vitorfleonardo/ESP32-Rocket-Telemetry/README.md

 

<h1 align="center">🚀 Foguete d'Água com Base Automatizada 🚀</h1>
<p align="center">
  Projeto Interdisciplinar - Faculdade UnB Gama<br>
  <strong>Engenharias Aeroespacial, Eletrônica, Software, Automotiva e Energia</strong> – 2025<br>
  <em>Controle de Trajetória, Automação e Análise de Dados</em>
</p>

---

## 📘 Sobre o Projeto

Este repositório contém o projeto **"Foguete d’Água com Base Automatizada"**, desenvolvido como parte da disciplina **Projeto Integrador de Engenharia 1 (PI1)** da Universidade de Brasília (UnB). O sistema foi concebido para realizar lançamentos de foguetes com **propulsão hidrostática** de forma segura, reutilizável e com **coleta de dados embarcada**.

> 🎯 **Objetivo**: Alcançar distâncias pré-definidas de 10 m, 20 m e 30 m com precisão de ±0.5 m, coletando e processando dados em tempo real por meio de um microcontrolador embarcado (ESP32). Após o voo, construir análises da trajetória.

---

## EQUIPE DO PROJETO

<div align="center">
  <h3>TIME DE HARDWARE</h3>
  <table>
    <tr>
      <td align="center">
      <a href="https://github.com/vitorfleonardo">
        
        <br />
        <b>Vitor Feijó</b>
        <br />
        <sub>Gerente do Projeto</sub>
      </a>
    </td>
    <td align="center">
      <a href="https://github.com/luidooo">
        
        <br />
        <b>Luis Lima</b>
        <br />
        <sub>Gerente de Hardware</sub>
      </a>
    </td>
    <td align="center">
      <a href="https://github.com/bottinolucas">
        
        <br />
        <b>Lucas Bottino</b>
        <br />
        <sub>Engenheiro de Hardware</sub>
      </a>
    </td>
    <td align="center">
      <a href="https://github.com/R-enanVieira">
        
        <br />
        <b>Renan Vieira</b>
        <br />
        <sub>Engenheiro de Hardware</sub>
      </a>
    </td>
    </tr>
  </table>

  <h3>TIME DE SOFTWARE</h3>
  <table>
    <tr>
      <td align="center">
        <a href="https://github.com/melohugo">
          
          <br />
          <b>Hugo Melo</b>
          <br />
          <sub>Gerente de Software</sub>
        </a>
      </td> 
      <td align="center">
        <a href="https://github.com/BeyondMagic">
          
          <br />
          <b>João V. Farias</b>
          <br />
          <sub>Engenheiro de Software</sub>
        </a>
      </td> 
      <td align="center">
        <a href="https://github.com/LuizaMaluf">
          
          <br />
          <b>Luiza Maluf</b>
          <br />
          <sub>Engenheira de Software</sub>
        </a>
      </td>
      <td align="center">
        <a href="https://github.com/Nanashii76">
          
          <br />
          <b>Paulo H. Lamounier</b>
          <br />
          <sub>Engenheiro de Software</sub>
        </a>
      </td>
      <td align="center">
        <a href="https://github.com/MillenaQueiroz">
          
          <br />
          <b>Millena Queiroz</b>
          <br />
          <sub>Engenheira de Software</sub>
        </a>
      </td>
    </tr>
  </table>

   <h3>TIME DE ESTRUTURAS</h3>
   <table>
    <tr>
      <td align="center">
        
        <br />
        <b>Ives Monteiro</b>
        <br />
        <sub>Gerente de Estruturas</sub>
      </td>
      <td align="center">
          
          <br />
          <b>Sophia Cordeiro</b>
          <br />
          <sub>Engenheira de Estruturas</sub>
      </td>
      <td align="center">
          
          <br />
          <b>Guilherme Carmona</b>
          <br />
          <sub>Engenheiro de Estruturas</sub>
      </td>
      <td align="center">
          
          <br />
          <b>Erik Moreira</b>
          <br />
          <sub>Engenheiro de Estruturas</sub>
      </td>
      <td align="center">
        <a href="https://github.com/kaedcanizo1">
          
          <br />
          <b>Kaed Caniz</b>
          <br />
          <sub>Engenheiro de Estruturas</sub>
        </a>
      </td>
    </tr>
  </table>

</div>

---

## 🛠️ Módulos do Projeto

<div align="center">
    <h3>ESTRUTURAS DA BASE DE LANÇAMENTO E DO FOGUETE</h3>
    Diagrama de Hardware
    <p> Imagem 1 - Construção, design e resultado final da Base de Lançamentos e do Foguete.</p>
</div>

<div>
    Na parte de estruturas, realizamos o design da Base de Lançamentos e do Foguete com o CAD, como exemplificado em (b). Logo em seguida iniciamos a montagem do foguete como em (a) e ao final obtivemos o resultado mostrado em (c).
</div>

---

<div align="center">
    <h3>HARDWARE DO FOGUETE</h3>
    Diagrama de Hardware
    <p> Imagem 2 - Evolução do protótipo do hardware interno do foguete.</p>
</div>

<div>
Iniciamos a construção do hardware com o prototipo (a), testando o MPU-6050 com o protocolo I2C com a ESP32. Logo após aumentamos a complexidade e testamos o sistema completo com ESP32, MPU-6050 e armazenamento no Micro SD, exeplificado no protitipo (b). Em seguida realizamos uma soldagem com barras de pino em uma placa perfurada, representado pelo prototipo (c). E por fim, soldando as baterias ao dispositivo obtivemos o protitipo final (d).
</div>

---

<div align="center">
    <h3>HARDWARE DA BASE DE LANÇAMENTOS</h3>
    Hardware da base
    <p> Imagem 3 - Dispositivo hardware da Base.</p>
</div>

<div>
Assim que a quantidade de pressão é ideial, com base na leitura do manômetro, ativa-se então o hardware da base que faz uma contagem regressiva de 10 segundos e atuomaticamente faz uma acionamento eletromecânico na base lançando o foguete. 
</div>

---

<div align="center">
    <h3>SOFTWARE DE TELEMETRIA</h3>
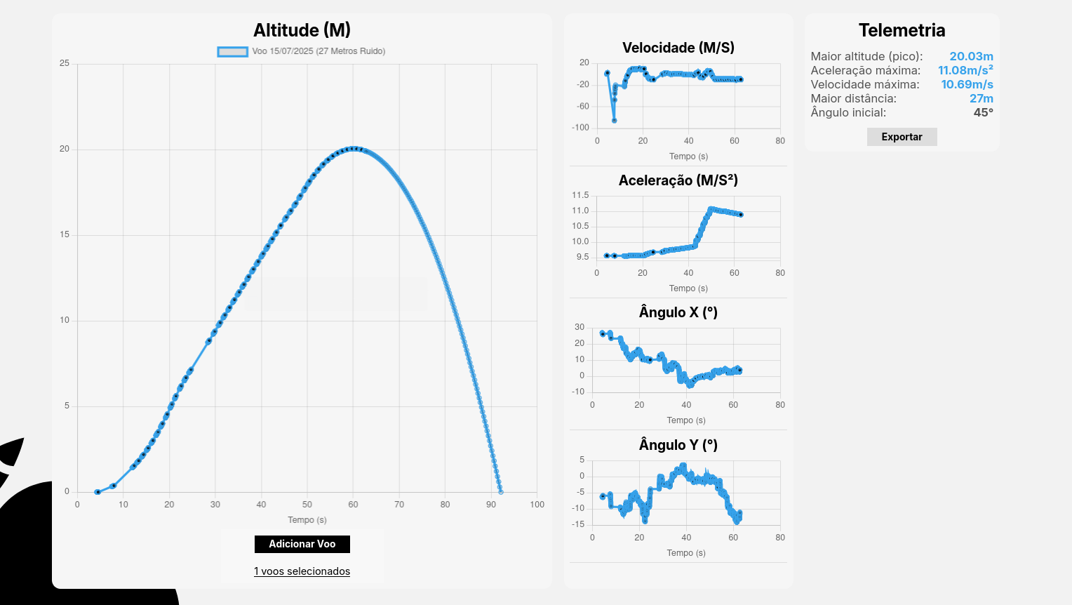
[picture p1: media/telemetria.jpeg]
Telemetria do Software
    
    <p> Imagem 4 - Software para análise do lançamento.</p>
</div>

<div>
Com o SD card do Harwade do Foguete conseguimos obter os dados de timestamp, acelerações linerares (ax, ay e az), giro (gx, gy e gz) e por um processamento que consiste em conversão e aplicação de formulas físicas podemos construir gráficos e análises da trajetória do foguete.
</div>

---

📜 Licença
MIT License © 2025 Foguete d'Água com Base Automatizada
