vitorfleonardo/ESP32-Rocket-Telemetry/software/latex/editaveis/01_abreviaturas.tex

\begin{siglas}
	\item[EAP] Estrutura Analítica do Projeto
	\item[TAP] Termo de Abertura do Projeto
	\item[SWOT] Forças (\textit{Strength}), Fraquezas (\textit{Weakness}), Oportunidades (\textit{Opportunities}), Ameaças (\textit{Threats})
	\item[PMBOK] \textit{Project Management Body of Knowledge} (guia das melhores práticas do gerenciamento de projetos)
	\item[CAD] Ferramenta para criação de desenhos técnicos
	\item[DER] Diagrama de Entidade e Relacionamento
	\item[BACKLOG] Lista de atividades de execução do projeto
	\item[FCTE] Faculdade de Ciências e Tecnologias de Engenharia
	\item[KICKOFF] uma reunião com a equipe do projeto e o cliente do projeto
	\item[BPMN] Business Process Model and Notation
	\item[PET] Tipo de plástico usado para fazer garrafas
	\item[TAP] Termo de Abertura de Projetos
	\item[AEB] Agência Espacial Brasileira
	\item[ESP32] Placa de desenvolvimento de hardware aberto
	\item[CLI] Interface de Linha de Comando
	\item[API] Interface de Programação de Aplicações
	\item[GUI] Interface Gráfica do Usuário
	\item[PSAI] Poliestireno de Alto Impacto
	\item[PVC] Policloreto de Vinila
	\item[CAD] Computer-Aided Design (Desenho Assistido por Computador)
	\item[CATIA] Computer-Aided Three-dimensional Interactive Application (Aplicação Interativa Assistida por Computador em Três Dimensões)
	\item[CSV] Comma-Separated Values (Valores Separados por Vírgula)
	\item[IMU] Unidade de Medição Inercial
	\item[SD] Secure Digital (Cartão de Memória)
	\item[PC] Personal Computer (Computador Pessoal)
\end{siglas}
