vitorfleonardo/ESP32-Rocket-Telemetry/software/README.md

# Projeto de Documentação

Este repositório contém o primeiro cliente de visualização em Python e a documentação em Markdown do programa.

## 🚀 Como rodar localmente

1. Clone o repositório:

```bash
git clone https://github.com/melohugo/PI1.git
cd PI1
```

1. Crie um ambiente virtual e instale as dependencias:

```bash
python -m venv .venv

source .venv/bin/activate  # no Linux/macOS
# ou
.venv\Scripts\activate  # no Windows

pip install -r requirements.txt
```

### Python

1. Instalar as depêndencias do cliente:

```bash
pip install -r source/requirements.txt
```

1. Executar programa:

```bash
python source/__init__.py
```

### Documentação

1. Executar a documentação

```bash
mkdocs serve
```

<!--
### Para mais detalhes de como contribuir, consulte o arquivo CONTRIBUTING.md

🛠️ Projeto em construção.
-->
