vitorfleonardo/ESP32-Rocket-Telemetry/software/docs/planejamento/tap.md

# Termo de Abertura do Projeto

## Nome do Projeto: Foguete de Água

Data de Início: 21/04/2025

Data Estimada de Término: 26/07/2025

## 1. Justificativa

Os alunos estão cursando a matéria Projeto Integrador 1 (PI1), e o desafio proposto é construir um foguete de água capaz de alcançar distâncias de 10, 20 e 30 metros. Para a parte de software, é necessário realizar uma análise dos dados coletados pelo foguete durante o voo.

## 2. Objetivos do Projeto

a. Objetivo Geral:

Desenvolver um foguete de água capaz de alcançar 10, 20 e 30 metros até o dia 06 de junho de 2025. O foguete não pode ser trocado durante a avaliação final.

b. Objetivos Específicos:

- Realizar análise dos dados adquiridos durante o lançamento.
- Elaborar um plano de projeto.
- Utilizar e documentar técnicas de gerenciamento de projeto.
- Aplicar testes nos componentes.

## 3. Escopo do Projeto

Incluído no Escopo:

- Levantamento e análise de requisitos.
- Confecção da documentação do sistema.
- Codificação da solução.
- Criação da documentação exigida pela matéria.

Fora do Escopo:

- Mudanças organizacionais de nível estratégico.
- Contratação de pessoal externo.
- Alterações na estrutura jurídica da empresa.

## 4. Premissas

- Os membros da equipe participarão ativamente das atividades.
- Haverá disponibilidade de tempo dos membros-chave para entrevistas e validações.
- O projeto terá apoio dos professores.

## 5. Restrições

- Orçamento limitado.
- Pouco conhecimento dos membros em temas específicos.
- Projeto executado com carga horária limitada.

## 6. Principais Partes Interessadas

- Membros da equipe.

## 7. Riscos Iniciais Identificados

- Baixo engajamento durante a implementação.
- Falta de conhecimento prévio sobre metodologias de gestão.
