vitorfleonardo/ESP32-Rocket-Telemetry/software/latex/editaveis/00_informacoes.tex

% Dados pessoais
\autor{Arthur Henrique Vieira, Erick Tavares, Guilherme Resende, Hugo Queiroz, Ives Monteiro, João Victor da Silva, Kaed Canizo, Leonardo Henrique, Lucas Gama, Luis Eduardo Castro, Luiza Maluf, Millena de Abreu, Natan Almeida, Paulo Henrique Lamounier, Renan Vieira, Sophia Souza, Sophia Ferreira, Vitor Feijó}
\curso{}

% Dados do trabalho
\titulo{Projeto de PI1}
\data{2025}
\palavraChaveUm{Projeto Integrador de Engenharia 1}
\palavraChaveDois{Faculdade UnB Gama}
\palavraChaveTres{Foguete d'água}
\palavraChaveQuatro{Controle de trajetória}
\palavraChaveCinco{Sistema embarcado}

% Dados da orientacao
\orientador{Prof. Ricardo Ajax Dias Kosloski}
\coorientador{Prof. Diogo Caetano Garcia, Prof. Juliana Petrocchi Rodrigues, Prof. Lui Txai Calvoso Habl e Prof. Rafael Rodrigues da Silva}

% % Dados para a ficha catalográfica
% \cdu{02:141:005.6}

% % Dados da aprovação do trabalho
% \dataDaAprovacao{01 de junho de 2013 -- Data da aprovação do trabalho}
% \membroConvidadoUm{Titulação e Nome do Professor Convidado 01}
% \membroConvidadoDois{Titulação e Nome do Professor Convidado 02}
