vitorfleonardo/ESP32-Rocket-Telemetry/software/latex/editaveis/05_equipe.tex

\begin{landscape}

\chapter{Equipe de Trabalho}

\begin{table}[htpb]
\begin{center}
\caption{Composição da equipe.}
\begin{tabular}{|c|c|c|c|c|c|c|}
\hline
\textbf{Iniciais} & \textbf{Nome} & \textbf{Matrícula} & \textbf{Curso} & \textbf{Telefone} & \textbf{E-mail} & \textbf{Atribuições}\\ \hline
AV & Arthur Vieira        & 23/1034064        & Eng. de Software      & (61) 98604-5333   & 231034064@aluno.unb.br   & Engenheiro de Software \\ \hline
EM & Erick Moreira         & 22/2022073        & Eng. de Aeroespacial  & (61) 99121-2563   & 222022073@aluno.unb.br   & Engenheiro de Estruturas \\ \hline
GC & Guilherme Carmona     & 22/1008070        & Eng. de Aeroespacial  & (61) 98128-8772   & 221008070@aluno.unb.br   & Engenheiro de Estruturas \\ \hline
HM & Hugo Melo             & 23/1034064        & Eng. de Software      & (61) 99547-0505   & 231034064@aluno.unb.br   & \textbf{Gerente} de \textit{Software} \\ \hline
IL & Ives Lemos            & 22/1008122        & Eng. de Aeroespacial  & (61) 99966-5115   & 221008122@aluno.unb.br   & \textbf{Gerente} de Estruturas \\ \hline
JF & João Farias           & 22/1022604        & Eng. de Software      & (61) 92002-3350   & 221022604@aluno.unb.br   & Engenheiro de \textit{Software} \\ \hline
KP & Kaed Prado            & 22/1008220        & Eng. de Aeroespacial  & (92) 98149-3839   & 221008220@aluno.unb.br   & Engenheiro de estruturas \\ \hline
LJ & Leonardo Junior       & 23/1035428        & Eng. de Software      & (61) 98531-1586   & 231035428@aluno.unb.br   & Engenheiro de Software \\ \hline
LB & Lucas Bottino         & 22/1008267        & Eng. de Software      & (61) 99149-8776   & 221008267@aluno.unb.br   & Engenheiro de \textit{Hardware} \\ \hline
LL & Luis Lima             & 22/1008285        & Eng. de Software      & (61) 99961-8010   & 221008285@aluno.unb.br   & \textbf{Gerente} de Hardware \\ \hline
LA & Luiza Amorim          & 22/1008294        & Eng. de Software      & (61) 99845-4712   & 221008294@aluno.unb.br   & Engenheiro de \textit{Software} \\ \hline
MQ & Millena Queiroz       & 20/2046283        & Eng. de Software      & (61) 99250-1026   & 202046283@aluno.unb.br   & Engenheiro de \textit{Software} \\ \hline
NA & Natan Almeida         & 22/2006169        & Eng. de Software      & (61) 99841-7222   & 222006169@aluno.unb.br   & Engenheiro de \textit{software} \\ \hline
PD & Paulo Dantas          & 22/1022408        & Eng. de Software      & (61) 98156-3664   & 221022408@aluno.unb.br   & Engenheiro de \textit{Software} \\ \hline
RG & Renan Guedes          & 22/1031363        & Eng. de Software      & (61) 99542-2260   & 221031363@aluno.unb.br   & Engenheiro de Hardware \\ \hline
SC & Sophia Cordeiro       & 22/1008454        & Eng. de Aeroespacial  & (18) 99783-6296   & 221008454@aluno.unb.br   & Engenheiro de Estruturas \\ \hline
SS & Sophia Silva          & 23/1026886        & Eng. de Software      & (61) 98260-6252   & 231026886@aluno.unb.br   & Engenheiro de \textit{software} \\ \hline
VL & Vitor Leonardo        & 22/1008516        & Eng. de Software      & (61) 99243-6348   & 221008516@aluno.unb.br   & \textbf{Gerente} do projeto \\ \hline
\end{tabular}
\end{center}
\end{table}

% \begin{table}[htpb]
% \begin{center}
% \caption{Avaliação de desempenho da equipe \textcolor{red}{(a ser preenchida na entrega final do projeto)}.}
% \begin{tabular}{|c|c|c|c|c|c|c|c|}
% \hline
%  & \textbf{Avaliação} & \textbf{Moti-} & \textbf{Comprome-} & \textbf{Conhecimento} & \textbf{Cumpriu} & \textbf{Comuni-} & \textbf{Gestão} \\
%  \textbf{Nome} & \textbf{geral} & \textbf{vação} & \textbf{timento} & \textbf{técnico} & \textbf{prazos} & \textbf{cação} & \textbf{de conflitos} \\ \hline
% Fulano & +++ & +++++ & +++++ & +++ & +++ & + & +++ \\ \hline
% Beltrano & +++ &  +++ & +++ & + & +++ & +++++ & +++ \\ \hline
% %  &  &  &  &  &  &  & em mais de uma linha \\\hline
% Ciclano & +++++ & +++ &  +++++ & +++ & +++ & +++ & +++  \\ \hline
%   &  &  &  &  &  &  &     \\ \hline
%   &  &  &  &  &  &  &     \\ \hline
%   &  &  &  &  &  &  &     \\ \hline
%   &  &  &  &  &  &  &     \\ \hline
%   &  &  &  &  &  &  &     \\ \hline
%   &  &  &  &  &  &  &     \\ \hline
%   &  &  &  &  &  &  &     \\ \hline
%   &  &  &  &  &  &  &     \\ \hline
%   &  &  &  &  &  &  &     \\ \hline
%   &  &  &  &  &  &  &     \\ \hline
%   &  &  &  &  &  &  &     \\ \hline
%   &  &  &  &  &  &  &     \\ \hline
% \multicolumn{8}{c}{\textit{Legenda}: +++++: \textit{atende às expectativas}; +++: \textit{requer pequenas melhorias}; +: \textit{requer grandes melhorias}.} 
% \end{tabular}
% \end{center}
% \end{table}

\end{landscape}
