vitorfleonardo/ESP32-Rocket-Telemetry/software/latex/figuras/capa-eps-converted-to.pdf

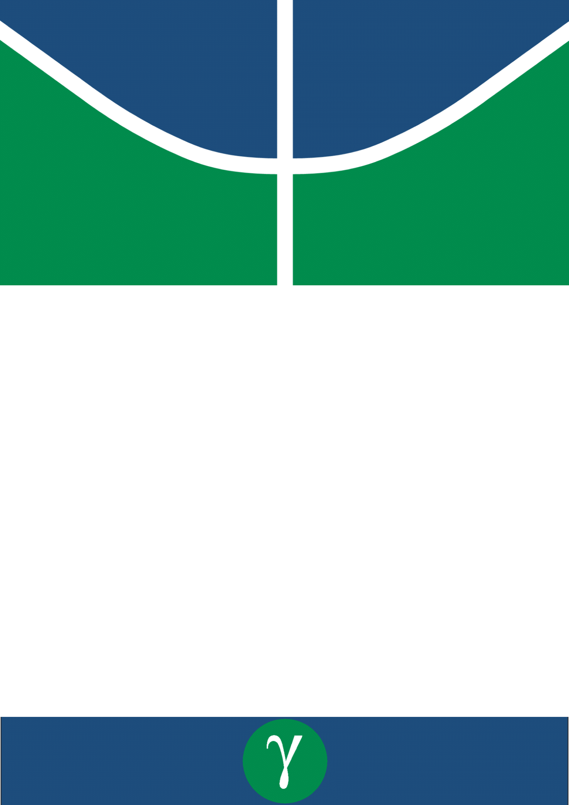
[picture p44: page 1]
