vitorfleonardo/ESP32-Rocket-Telemetry/media/CCC38DA5-3B44-47A4-BD88-0B7C26B4D97B.JPG

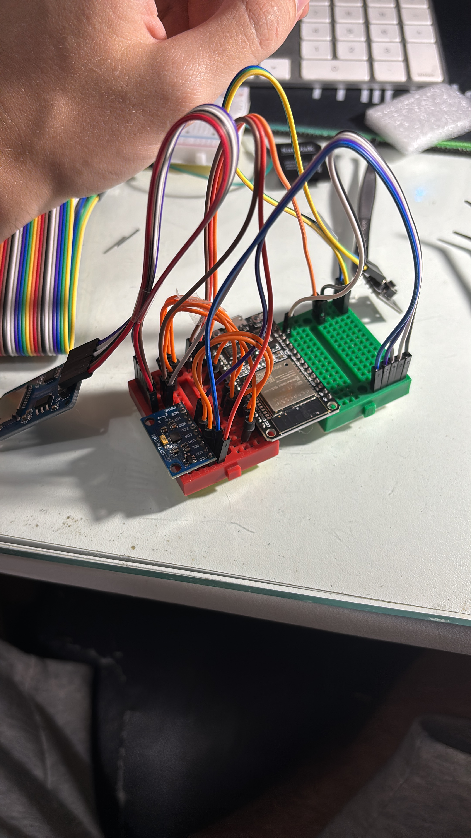
media/CCC38DA5-3B44-47A4-BD88-0B7C26B4D97B.JPG
