vitorfleonardo/ESP32-Rocket-Telemetry/media/foto.jpg

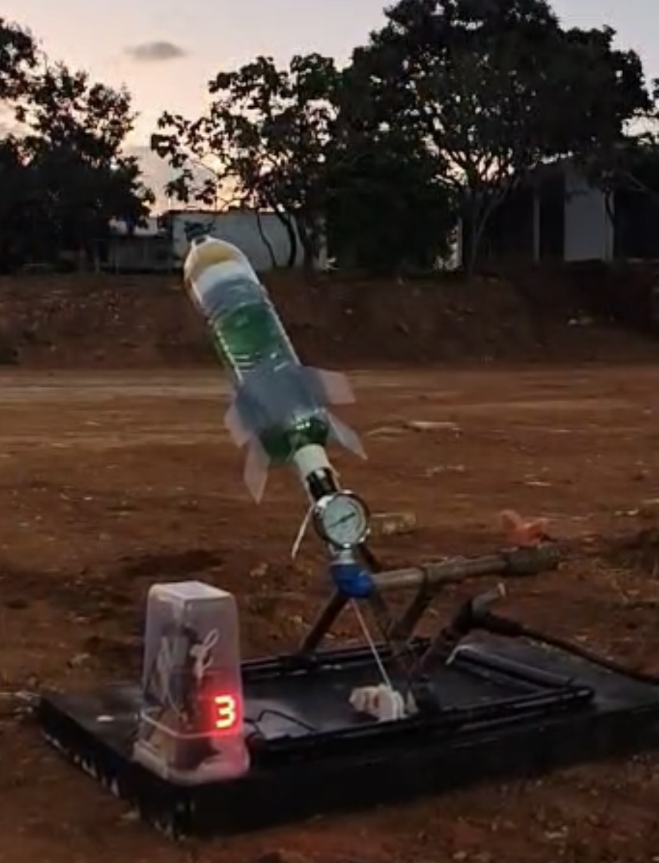
media/foto.jpg
