vitorfleonardo/ESP32-Rocket-Telemetry/media/hardware_1.JPG

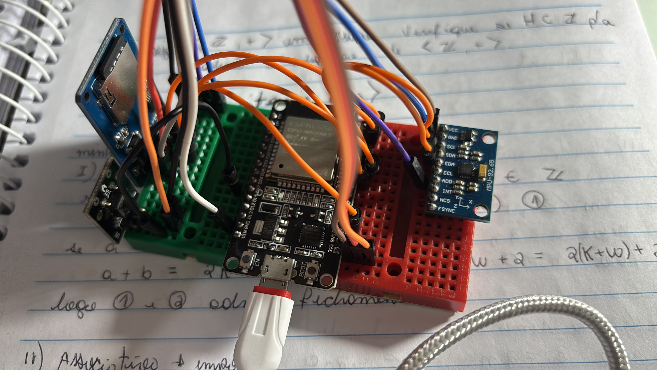
media/hardware_1.JPG
