vitorfleonardo/ESP32-Rocket-Telemetry/media/hardware_2.jpg

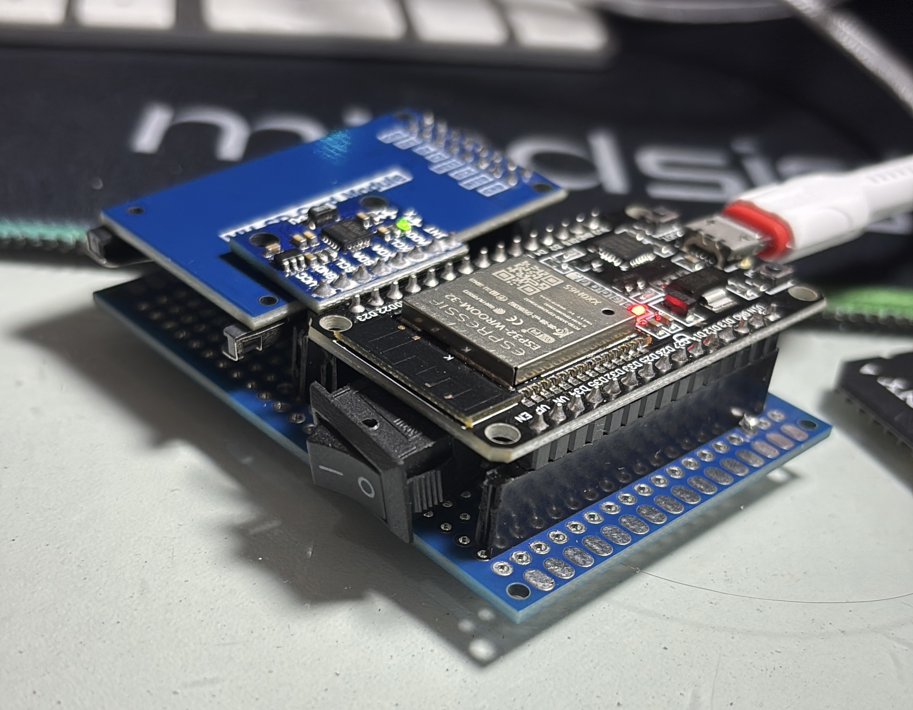
media/hardware_2.jpg
