vitorfleonardo/ESP32-Rocket-Telemetry/software/latex/figuras/arquitetura.png

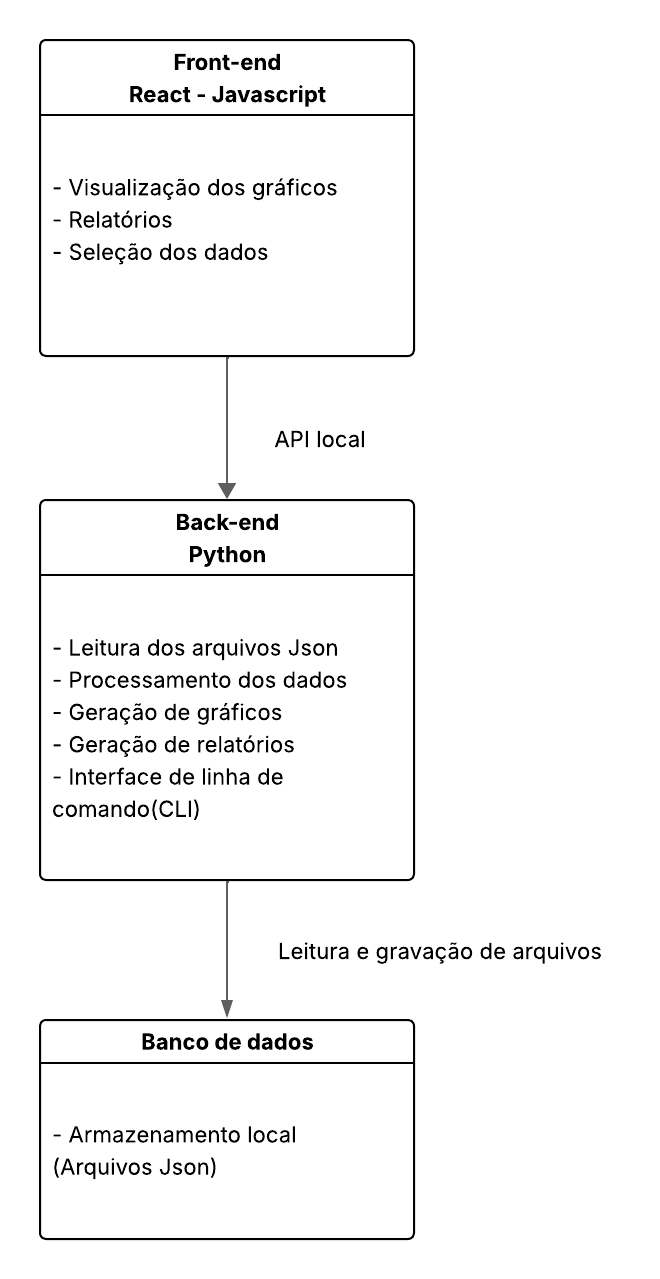
software/latex/figuras/arquitetura.png
