vitorfleonardo/ESP32-Rocket-Telemetry/software/latex/figuras/back_log.png

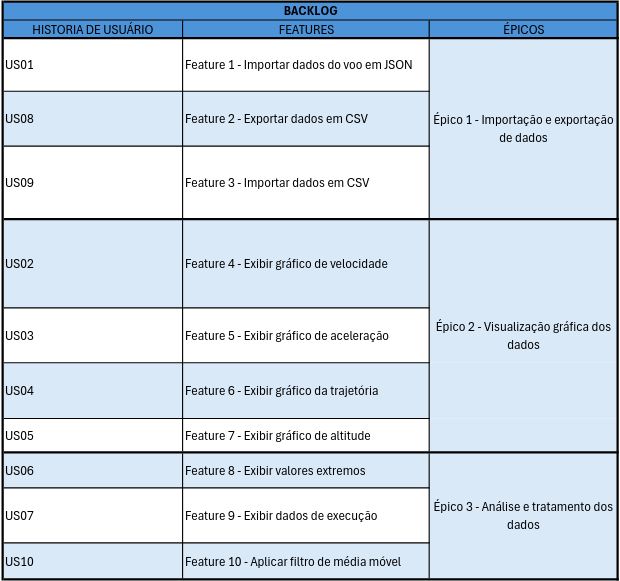
software/latex/figuras/back_log.png
