vitorfleonardo/ESP32-Rocket-Telemetry/software/latex/figuras/bpmn.png

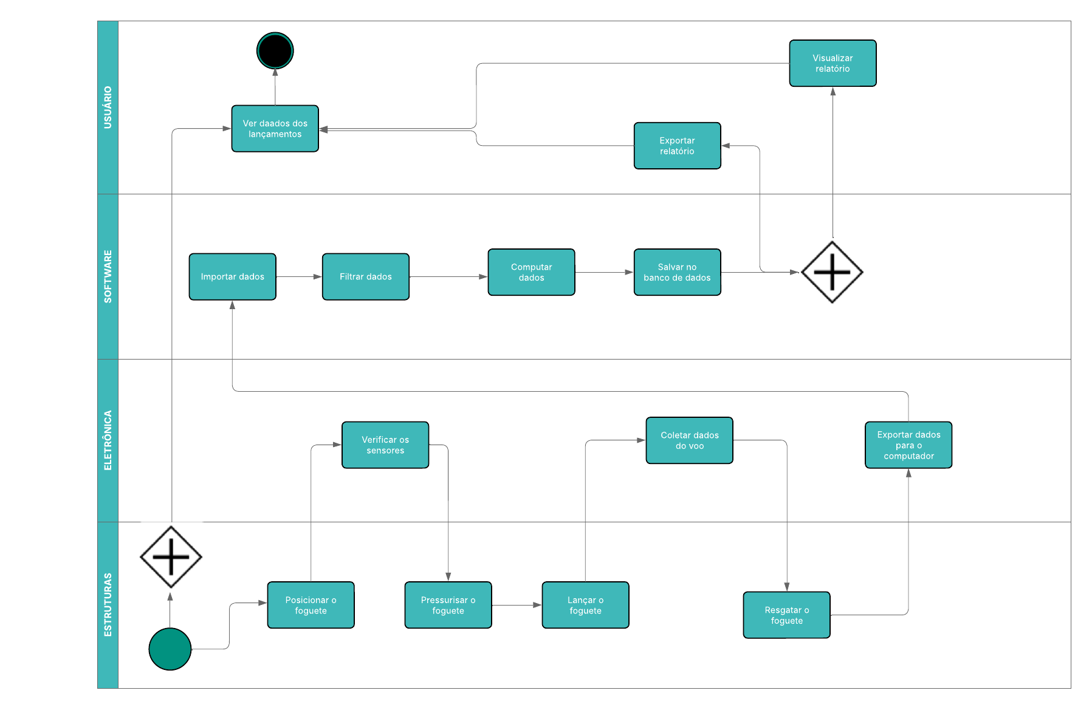
software/latex/figuras/bpmn.png
