vitorfleonardo/ESP32-Rocket-Telemetry/software/latex/figuras/der.png

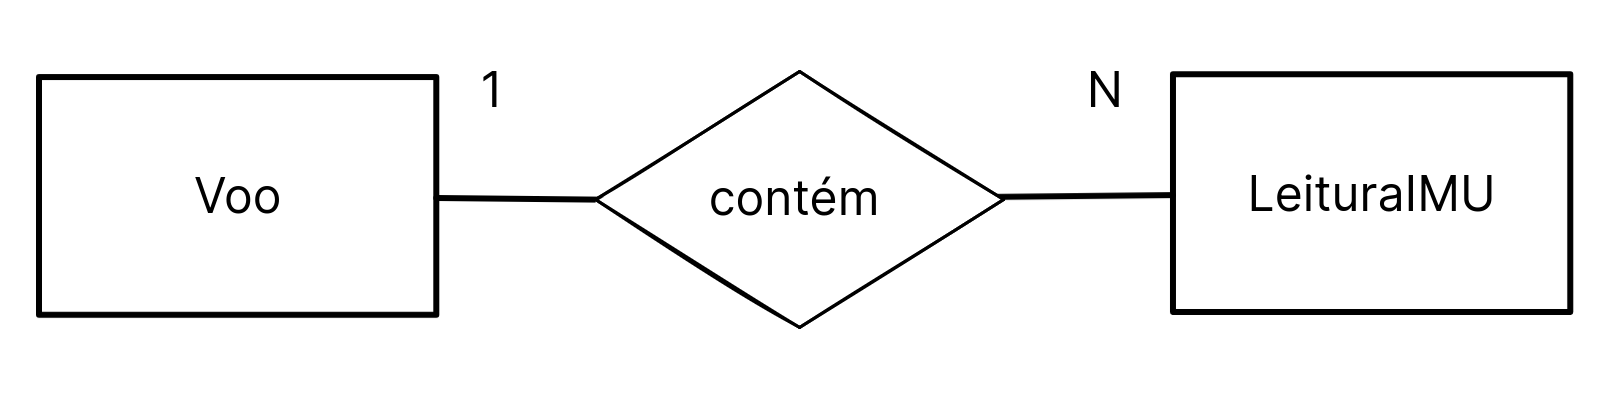
software/latex/figuras/der.png
