vitorfleonardo/ESP32-Rocket-Telemetry/software/latex/figuras/diagrama_de_estados.png

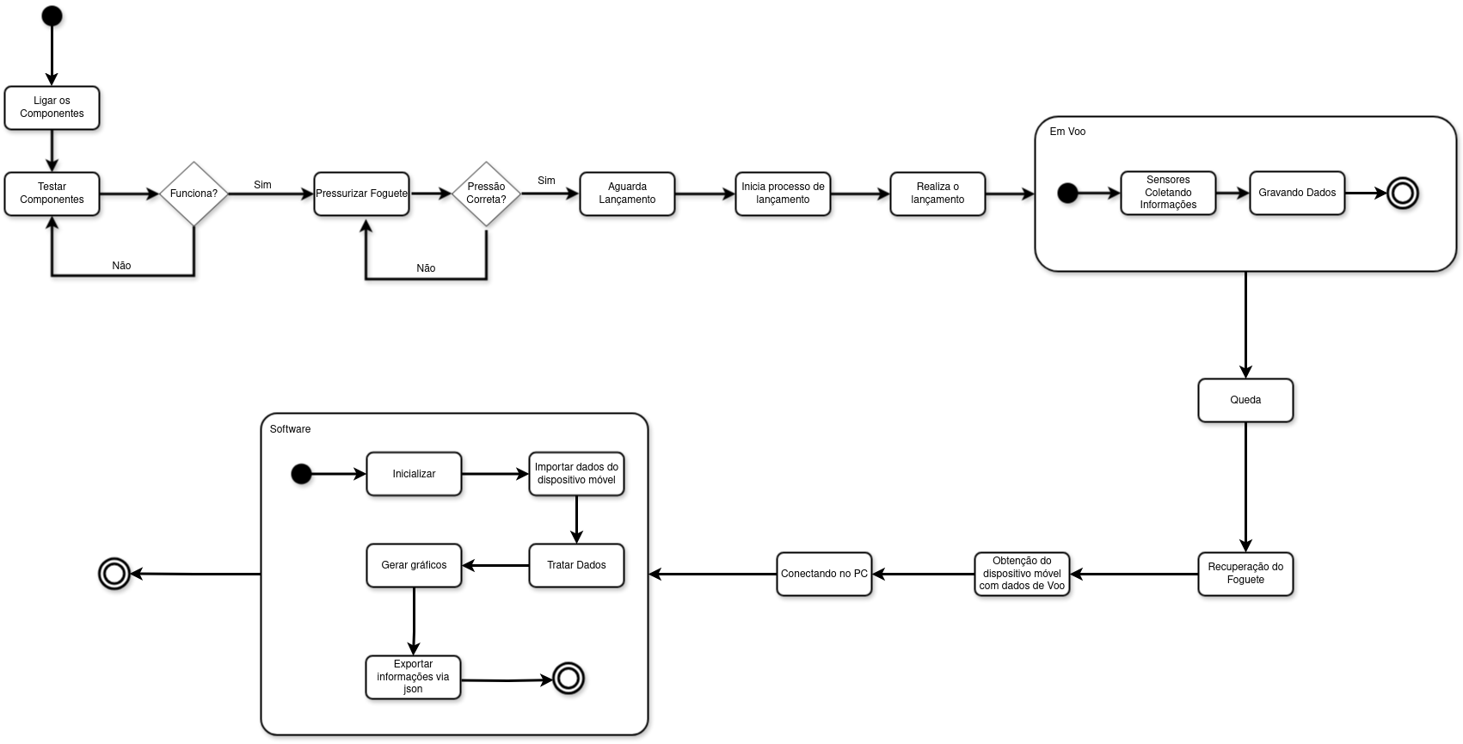
software/latex/figuras/diagrama_de_estados.png
