vitorfleonardo/ESP32-Rocket-Telemetry/software/latex/figuras/hardware/Análise SWOT PI1.png

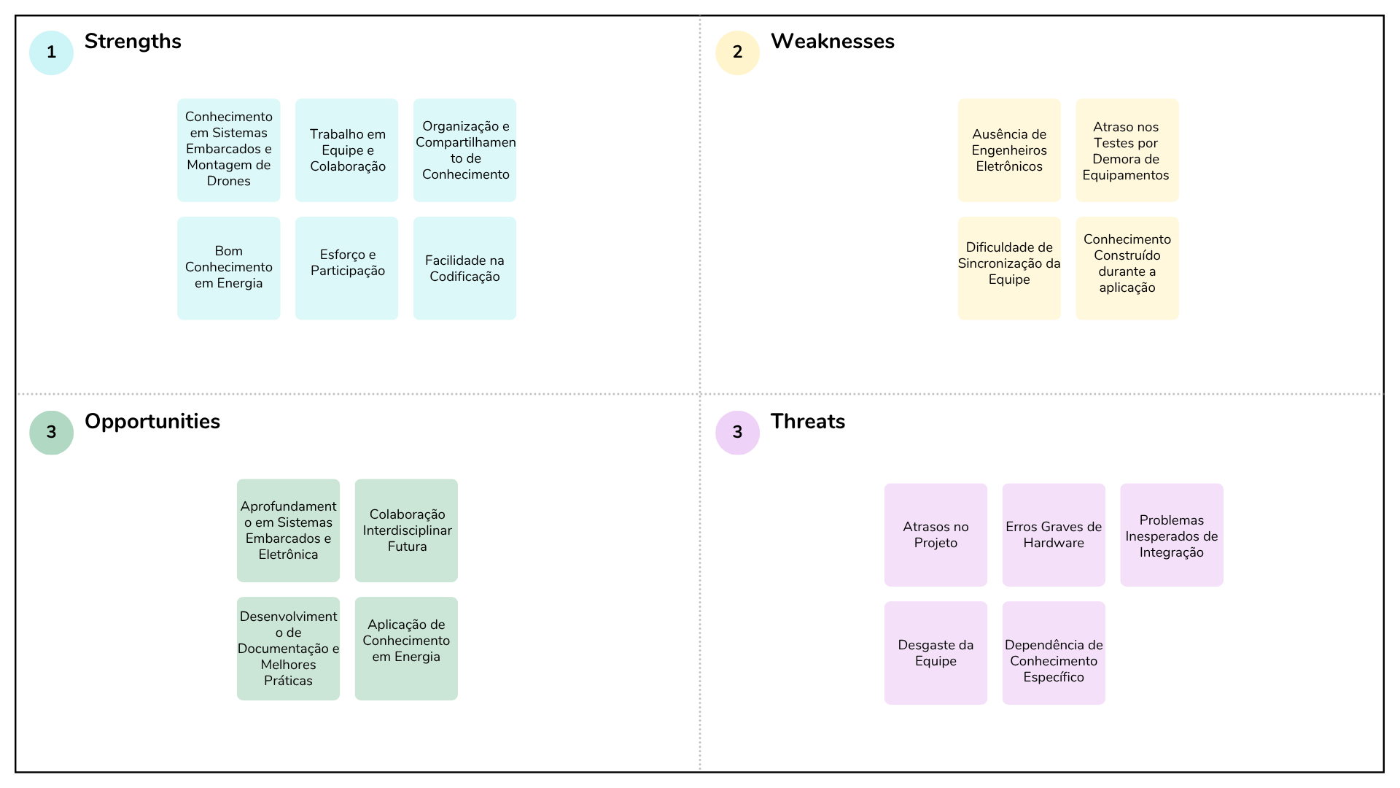
software/latex/figuras/hardware/Análise SWOT PI1.png
