vitorfleonardo/ESP32-Rocket-Telemetry/software/latex/figuras/hardware/diagramaFirmware.png

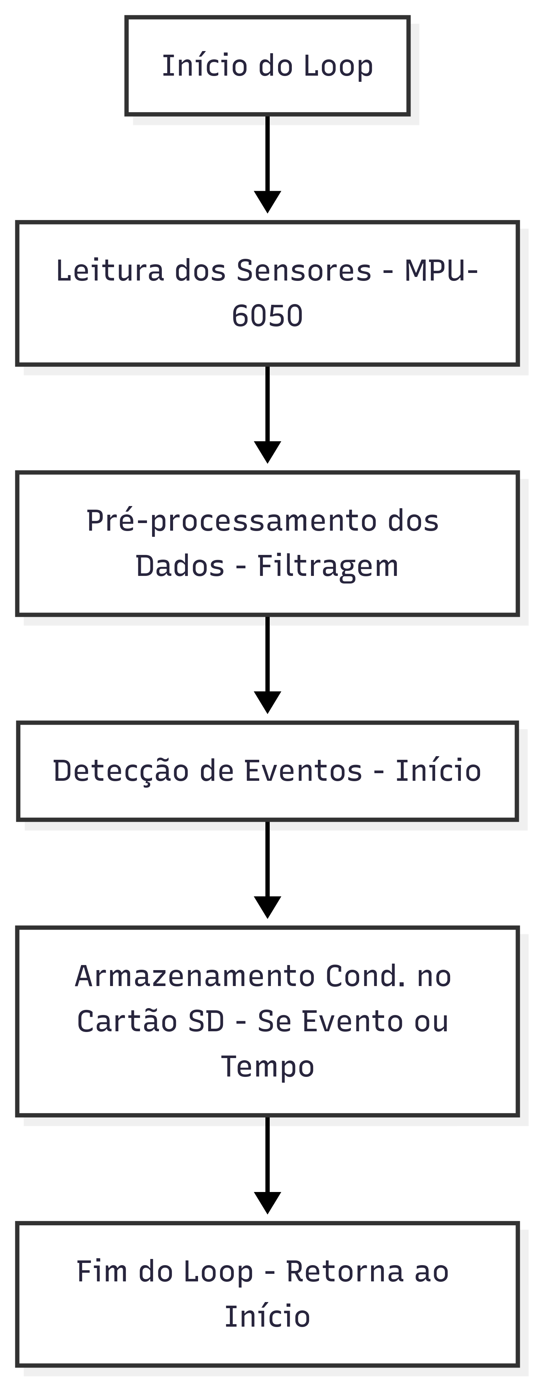
software/latex/figuras/hardware/diagramaFirmware.png
