vitorfleonardo/ESP32-Rocket-Telemetry/software/latex/figuras/hardware/esquematico.PNG

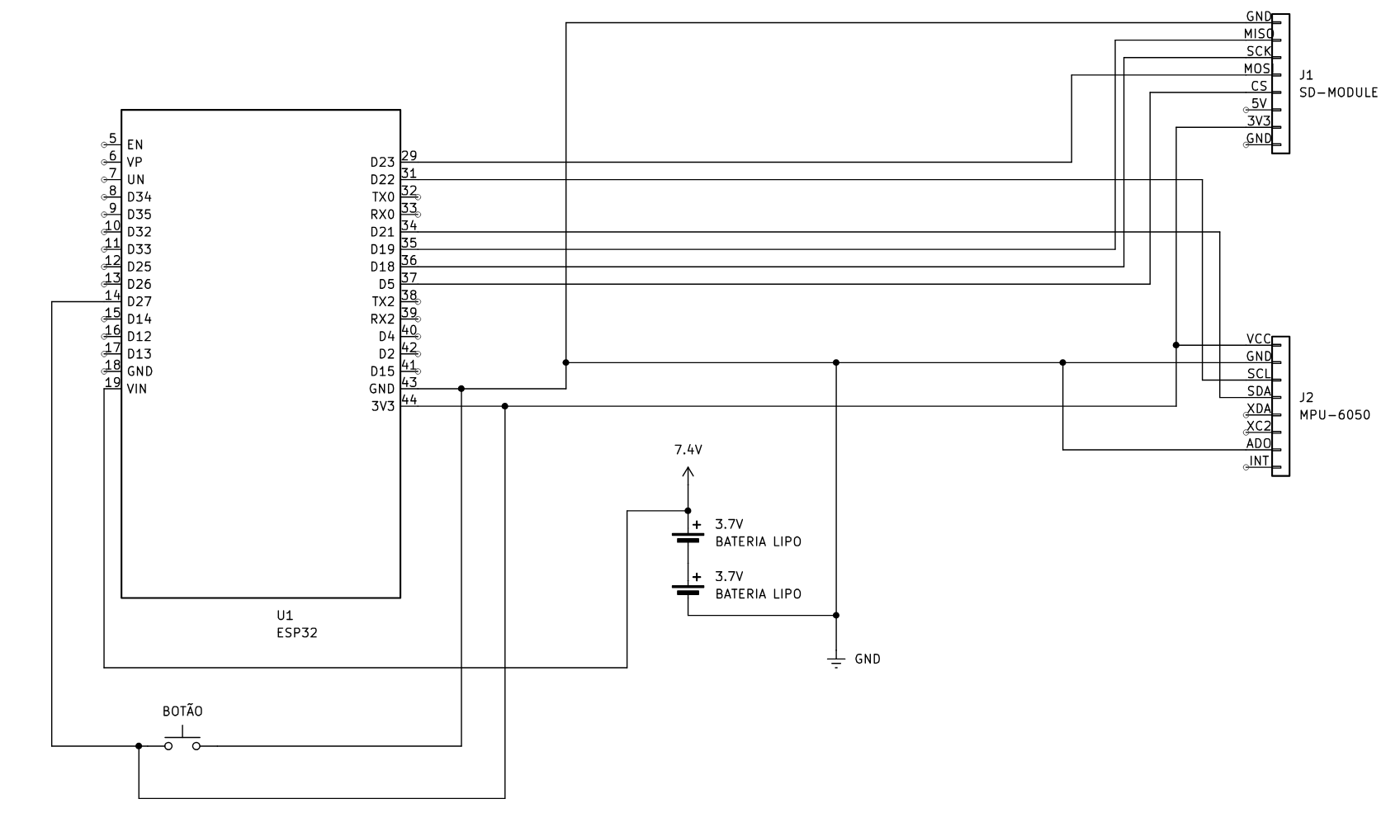
software/latex/figuras/hardware/esquematico.PNG
