vitorfleonardo/ESP32-Rocket-Telemetry/software/latex/figuras/hardware/esquematicoBase.PNGesquematicoBase.PNG

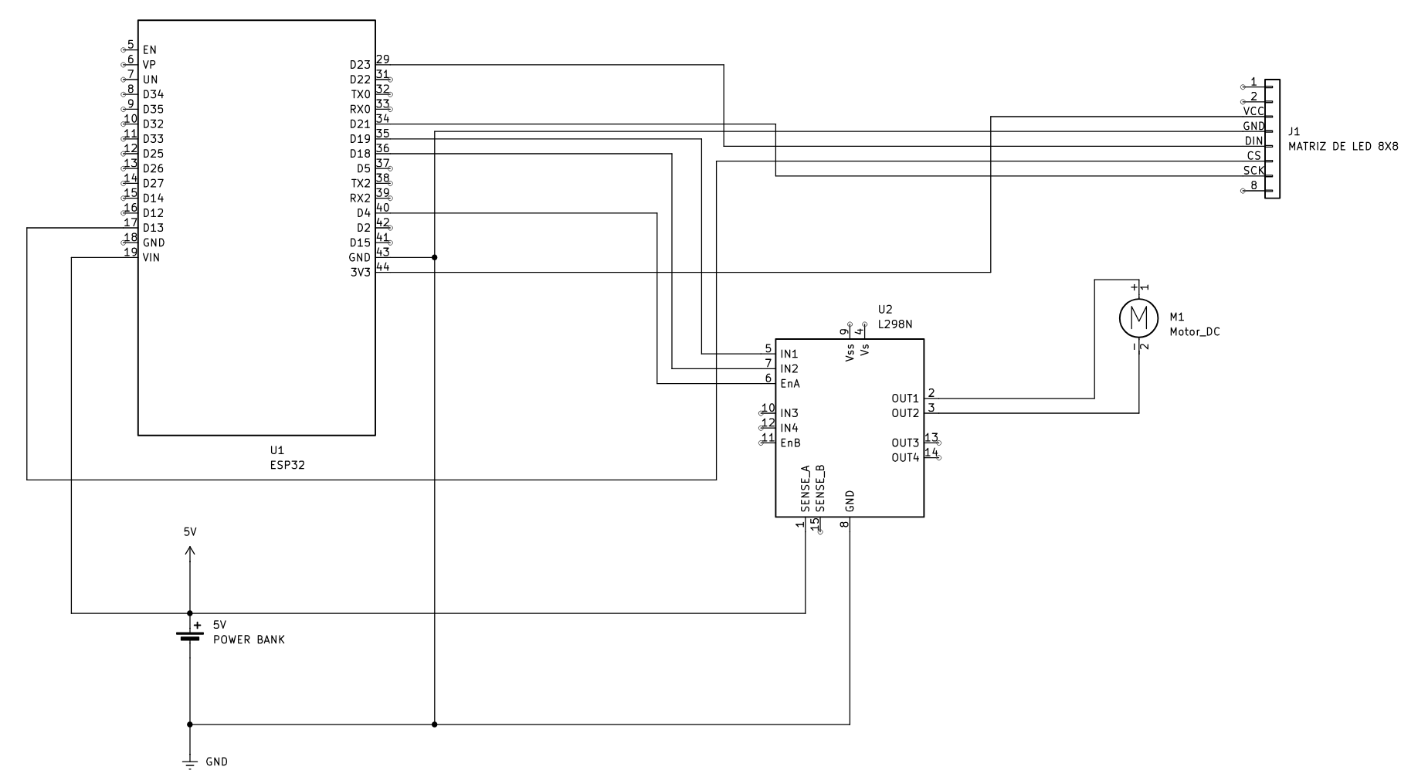
software/latex/figuras/hardware/esquematicoBase.PNGesquematicoBase.PNG
