vitorfleonardo/ESP32-Rocket-Telemetry/software/latex/figuras/historia_de_usuario.png

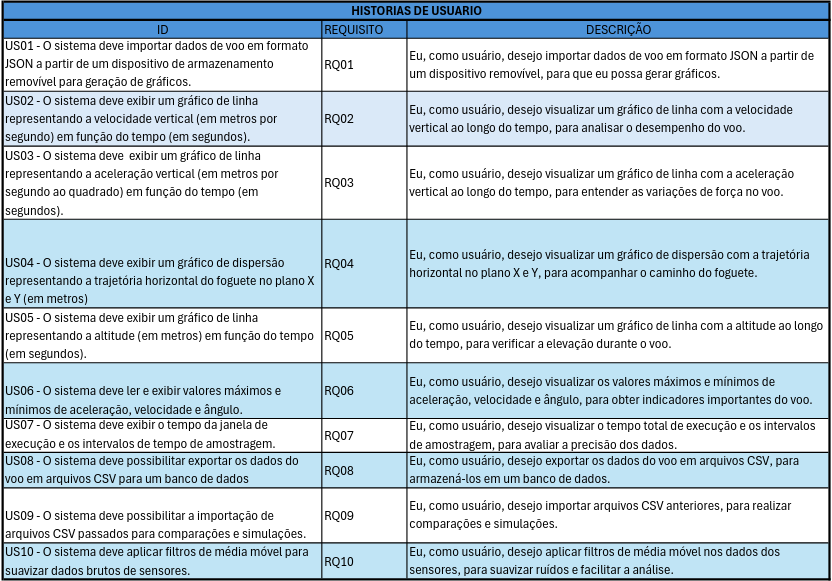
software/latex/figuras/historia_de_usuario.png
