vitorfleonardo/ESP32-Rocket-Telemetry/software/latex/figuras/moscow.png

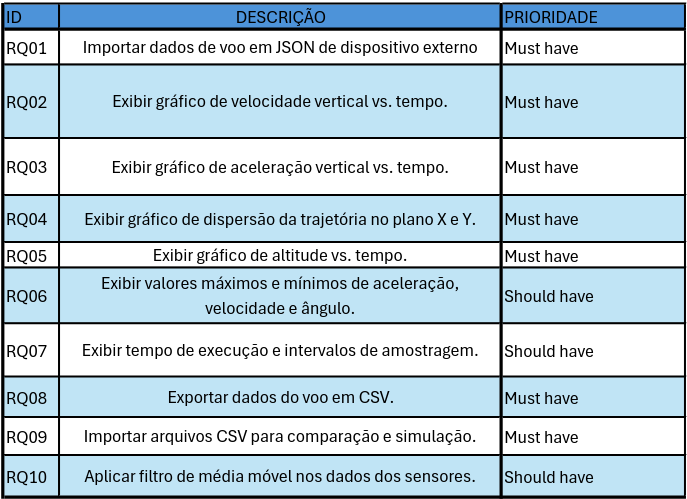
software/latex/figuras/moscow.png
