vitorfleonardo/ESP32-Rocket-Telemetry/software/latex/figuras/requisitos.png

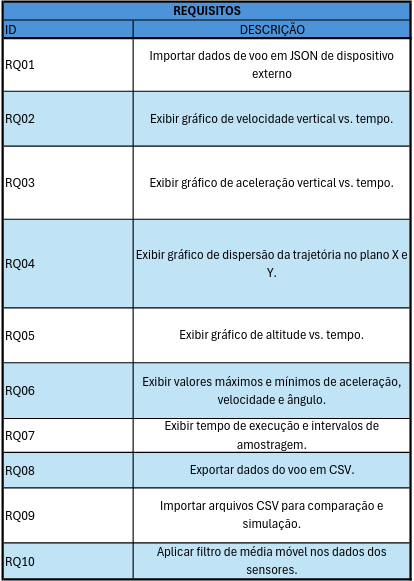
software/latex/figuras/requisitos.png
