vitorfleonardo/ESP32-Rocket-Telemetry/software/latex/figuras/software/graficos.jpeg

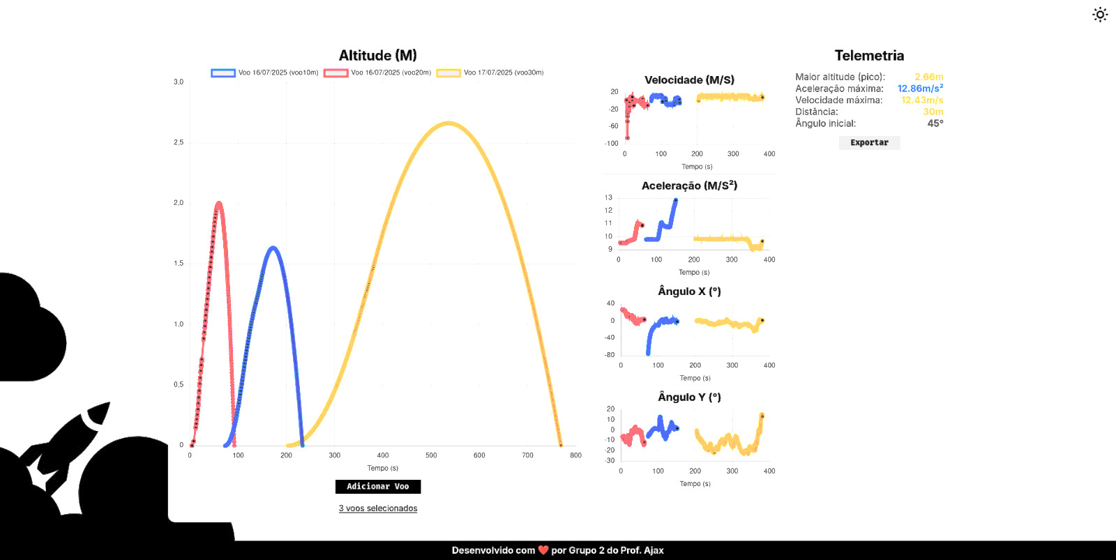
software/latex/figuras/software/graficos.jpeg
