vitorfleonardo/ESP32-Rocket-Telemetry/(commit log)

2025-05-01 docs: arruma tap.md para o markdownlint
2025-05-26 docs(readme): explicar passo a passo de instalacao
2025-06-01 feat(source.utils): adc funcao ask com comentário e tipo correto
2025-06-01 feat(source.types): adc IMUReading e FlightData
2025-06-01 feat(source.database): add todos os voos de testes ate agora
2025-06-01 feat(source.modules): adc selecianor de voo
2025-06-01 feat(source.modules): adc grafico de vlc angular, acel, vel
2025-06-01 feat(source.main): adc mais opcoes de grafico e escolha
2025-06-01 docs(latex): add ed2 revisao de software
2025-06-01 docs(latex): atualizar img casos de uso
2025-06-02 docs(latex): mudar o diagrama de blocos
2025-06-02 docs(latex): adc cronograma e esquematicos
2025-06-02 docs(latex): adc relatorio de energia
2025-06-11 feat: base para o frontend da analise dos dados dos voos
2025-06-12 feat: modificando estilos e incio da logica de selecionar voos
2025-07-02 Codigo funcional para arduino
2025-07-02 feat(source): criando importação dos dados .csv
    [dados.csv]
2025-07-08 codigo funcional para dispositivo soldado
2025-07-11 feat: arrumando selecao do voos e estilizacao
    arrumando selecao de voos na mesma data e adicionando algumas estilizacoes
2025-07-12 feat(latex): terminar relatorio de software
2025-07-12 feat(latex): adc fonte de diagrama de estados
2025-07-14 feat(latex): adc correcoes de hardware
2025-07-15 ajustes de imagens
2025-07-15 feat(front): finalizar altitude de voo normal
2025-07-15 feat(front): adc mais suavizador de calc
2025-07-16 adiciona codigo final de hardware foguete
2025-07-18 feat(latex): adc pdf
2025-07-18 feat(latex): adc integracao e licoes (#14)
